measurify/example-plant-care/edge/sketch_tesi/arduino_secrets.h

#define SECRET_SSID "Vodafone-A40733384"//"Galaxy mino"
#define SECRET_PASS "HAxNmy6spK9mCNqt"//"hTa5JkL68a"
#define SECRET_TOKEN "DVC eyJhbGciOiJIUzI1NiIsInR5cCI6IkpXVCJ9.eyJkZXZpY2UiOnsiZmVhdHVyZXMiOlsibW9uaXRvcmluZyJdLCJ0aGluZ3MiOlsidmluZTEiXSwidmlzaWJpbGl0eSI6InB1YmxpYyIsInBlcmlvZCI6IjVzIiwiY3ljbGUiOiIxMG0iLCJyZXRyeVRpbWUiOiIxMHMiLCJfaWQiOiJlZGdlLXZpbmUxIiwib3duZXIiOiI2NThkZDI5NmUzZjQzNDAwMzE1MTQwOTUifSwidGVuYW50Ijp7InBhc3N3b3JkaGFzaCI6dHJ1ZSwiX2lkIjoiUGxhbnQtVGVuYW50Iiwib3JnYW5pemF0aW9uIjoiTWVhc3VyaWZ5IG9yZyIsImFkZHJlc3MiOiJNZWFzdXJpZnkgU3RyZWV0LCBHZW5vdmEiLCJlbWFpbCI6ImluZm9AbWVhc3VyaWZ5Lm9yZyIsInBob25lIjoiKzM5MTAzMjE4NzkzODE3IiwiZGF0YWJhc2UiOiJQbGFudC1UZW5hbnQifSwiaWF0IjoxNzAzNzkzODAxLCJleHAiOjMzMjYxMzkzODAxfQ.oyHKERZanvmHalvWGUH-B606oOZXUkqiPO5CvLCflgU"
